GuitarML/GuitarPedalPCBs/ClassicBoost_1590a/pics/pcb_filled.jpg

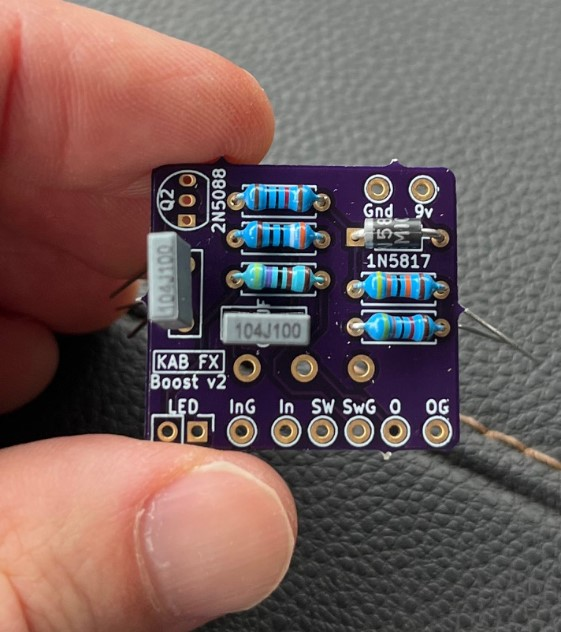
ClassicBoost_1590a/pics/pcb_filled.jpg
