GuitarML/GuitarPedalPCBs/ClassicBoost_1590a/ClassicBoost_v2.kicad_pcb

## KiCad design ClassicBoost_1590a/ClassicBoost_v2.kicad_pcb (2023-12-01)

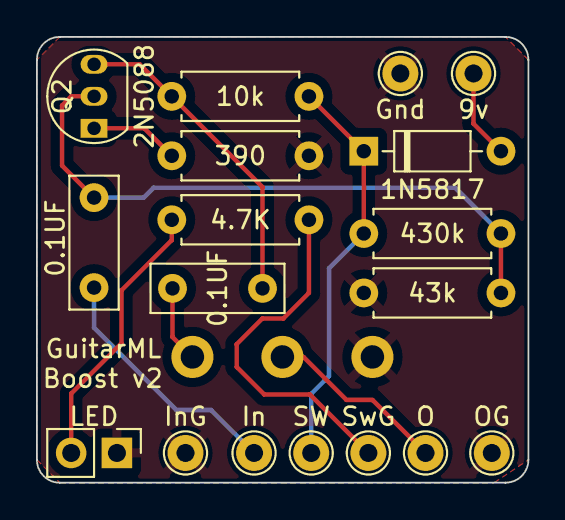
[picture p4: board ClassicBoost_v2.kicad_pcb from above]

Board: 2 copper layers, 27.3 x 24.8 mm, 19 parts (0 on the bottom side), 11 nets.

Parts:
9v: TestPoint_THTPad_D2.0mm_Drill1.0mm
C1, C2: 0.1UF; C_Rect_L7.2mm_W2.5mm_P5.00mm_FKS2_FKP2_MKS2_MKP2
D1: 1N5817; D_DO-35_SOD27_P7.62mm_Horizontal
Gnd: TestPoint_THTPad_D2.0mm_Drill1.0mm
In: TestPoint_THTPad_D2.0mm_Drill1.0mm
InG: TestPoint_THTPad_D2.0mm_Drill1.0mm
LED: PinHeader_1x02_P2.54mm_Vertical
O: TestPoint_THTPad_D2.0mm_Drill1.0mm
OG: TestPoint_THTPad_D2.0mm_Drill1.0mm
POT1: 100K; Potentiometer_Omeg_PC16BU_Vertical
Q2: 2N5088; TO-92_Inline
R1: 430k; R_Axial_DIN0207_L6.3mm_D2.5mm_P7.62mm_Horizontal
R2: 43k; R_Axial_DIN0207_L6.3mm_D2.5mm_P7.62mm_Horizontal
R3: 10k; R_Axial_DIN0207_L6.3mm_D2.5mm_P7.62mm_Horizontal
R4: 390; R_Axial_DIN0207_L6.3mm_D2.5mm_P7.62mm_Horizontal
R5: 4.7K; R_Axial_DIN0207_L6.3mm_D2.5mm_P7.62mm_Horizontal
SW: TestPoint_THTPad_D2.0mm_Drill1.0mm
SwG: TestPoint_THTPad_D2.0mm_Drill1.0mm

Connections:
GND: Gnd.1, InG.1, LED.1 (K), OG.1, POT1.1, R2.1, R4.1
unnamed: 9v.1, D1.2 (A)
unnamed: C2.2, POT1.3
unnamed: D1.1 (K), R1.2, R3.2, SW.1
unnamed: C1.1, In.1
unnamed: LED.2 (A), R5.1
unnamed: O.1, POT1.2
unnamed: C1.2, Q2.2 (B), R1.1, R2.2
unnamed: C2.1, Q2.3 (C), R3.1
unnamed: Q2.1 (E), R4.2
unnamed: R5.2, SwG.1
